jeremyxu2015/glow-plot-clock/stls/Arm3.STL

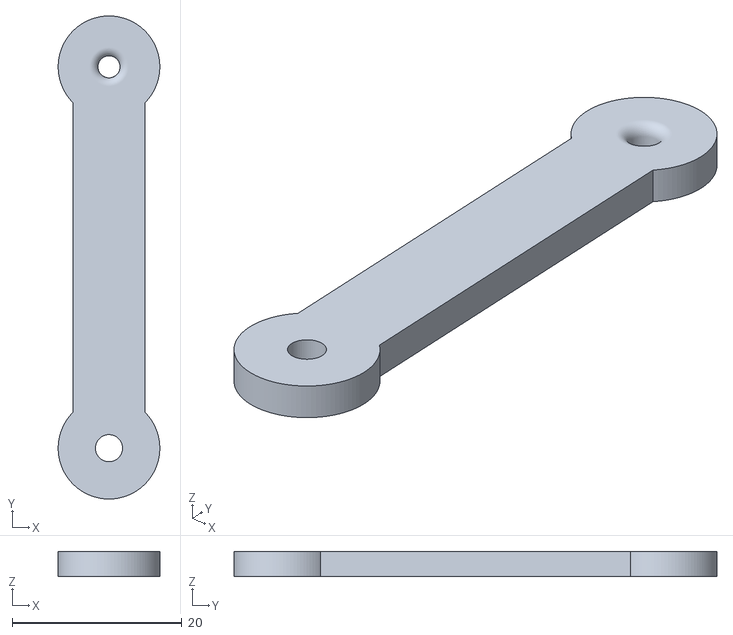
[picture p1: CAD file, 2026-09-19]
stls/Arm3.STL
12.0 x 57.0 x 3.00
