jeremyxu2015/glow-plot-clock/stls/Arm4.STL

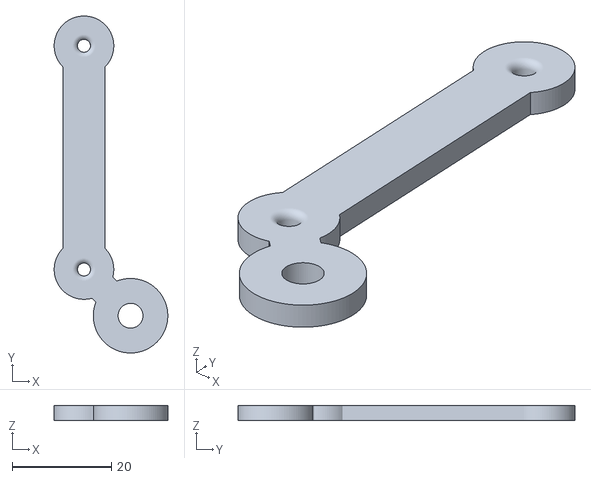
[picture p2: CAD file, 2026-09-19]
stls/Arm4.STL
22.9 x 67.8 x 3.00
