jeremyxu2015/glow-plot-clock/stls/Case_Top_Human.stl

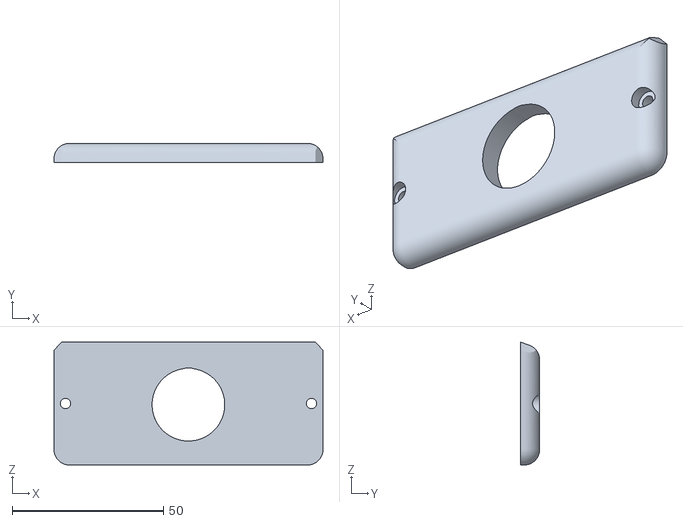
[picture p3: CAD file, 2026-09-19]
stls/Case_Top_Human.stl
88.9 x 6.35 x 40.6
