jeremyxu2015/glow-plot-clock/stls/Arm1-2.STL

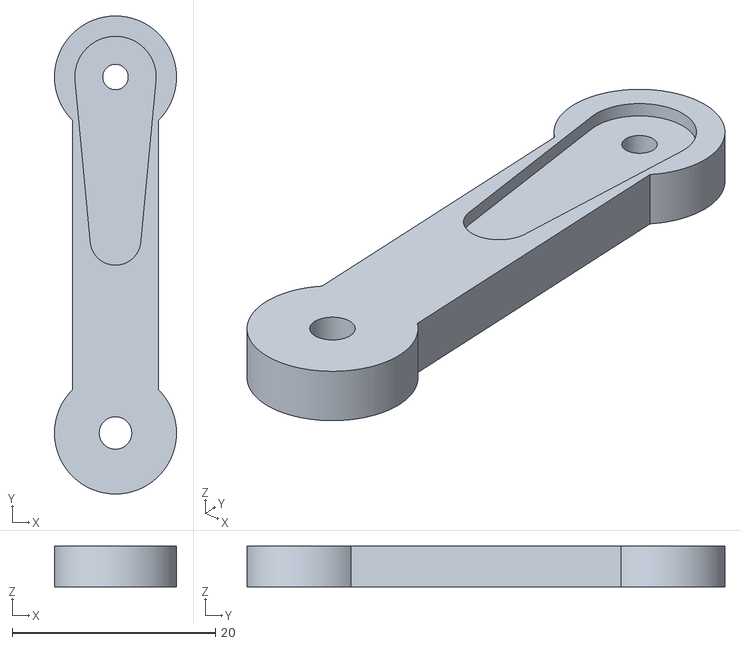
[picture p4: CAD file, 2026-09-19]
stls/Arm1-2.STL
12.0 x 47.0 x 4.00
