jeremyxu2015/glow-plot-clock/stls/led_cover.STL

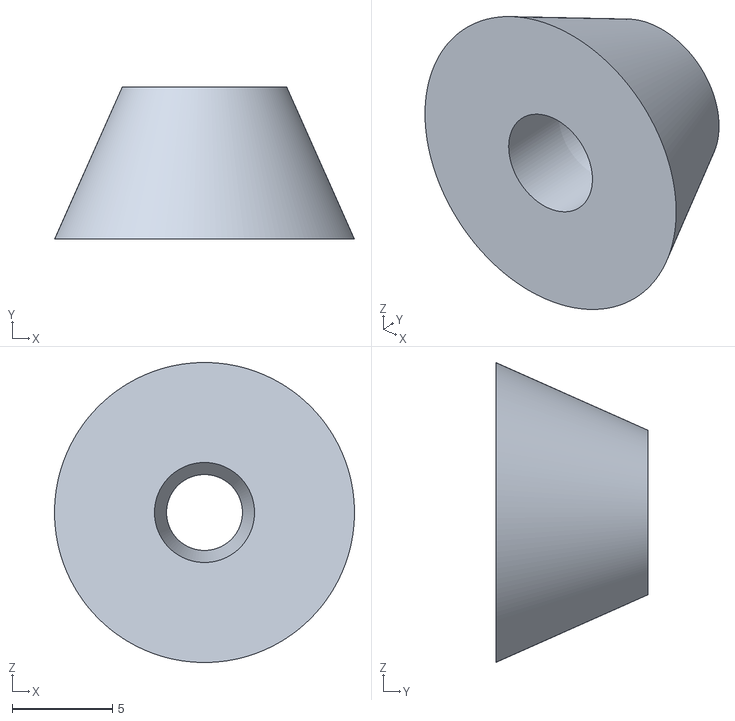
[picture p5: CAD file, 2026-09-19]
stls/led_cover.STL
15.0 x 7.62 x 15.0
