jeremyxu2015/glow-plot-clock/stls/Case.STL

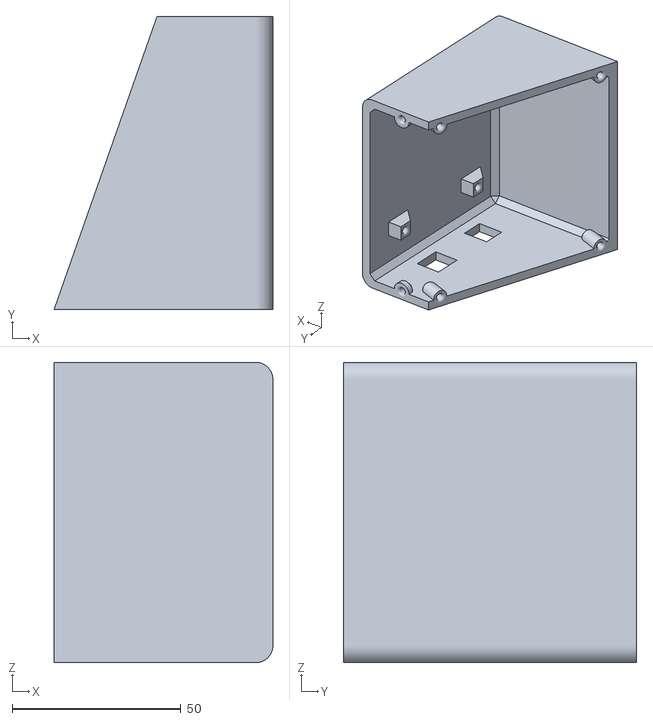
[picture p6: CAD file, 2026-09-19]
stls/Case.STL
64.8 x 86.7 x 88.9
