jeremyxu2015/glow-plot-clock/stls/Case_Front.STL

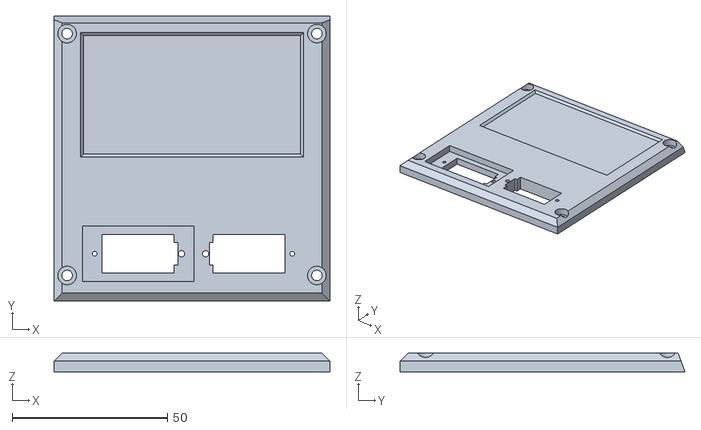
[picture p8: CAD file, 2026-09-19]
stls/Case_Front.STL
88.9 x 91.9 x 6.00
