jeremyxu2015/glow-plot-clock/(commit log)

2026-09-19 Plot Clock ESP8266 改造版：固件、STL 与装配指南
    [Arm1-2.STL, Arm3.STL, Arm4.STL, Case.STL, Case_Front.STL, Case_Top.STL, Case_Top_Human.stl, led_cover.STL]
2026-09-19 新增 ESP32-C3 SuperMini 版固件与网页双版本切换
2026-09-25 新增经典 ESP32 mini(WROOM-32) 版：固件与网页三主控切换
